Ttl/reflow-controller/software/microprocessor/LUFA/StudioIntegration/VSIX/ASFExplorer.png

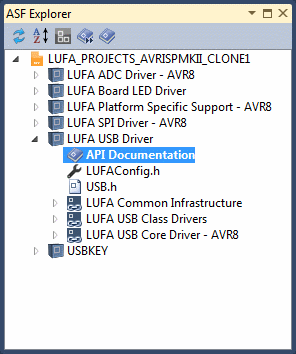
software/microprocessor/LUFA/StudioIntegration/VSIX/ASFExplorer.png
