Ttl/reflow-controller/software/microprocessor/LUFA/StudioIntegration/VSIX/ASFWizard.png

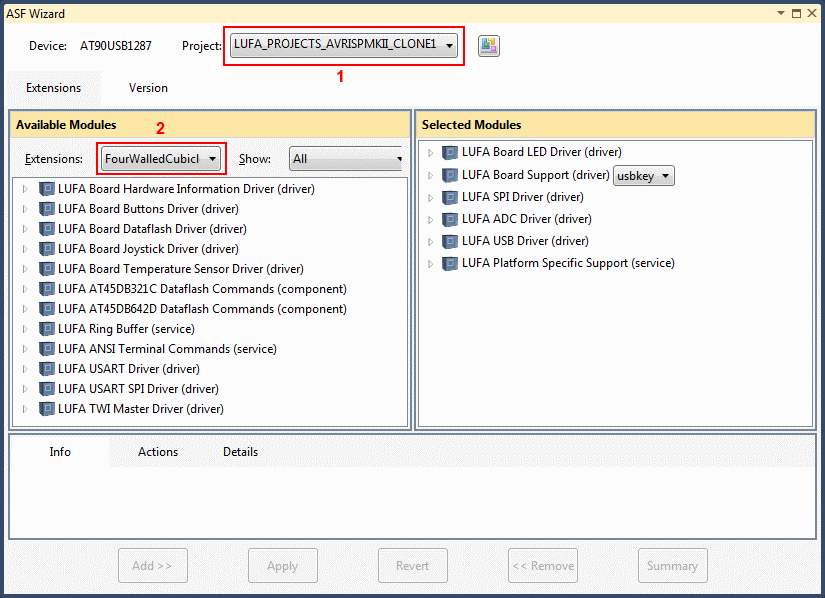
software/microprocessor/LUFA/StudioIntegration/VSIX/ASFWizard.png
