Ttl/reflow-controller/(commit log)

2013-09-08 Add schematic and board
    [uuni.brd, uuni.sch]
2014-05-11 Implement modifying the reflow profile
    Also pretty prints the status output messages
2014-07-15 Add a plot of the target and current temperatures
2026-02-08 Python 3 update and add hold temperature mode
